sinitsinmike/Build-your-own-SH-101-CV-GATE-sequencer-/picture_pc_d4e4c39e6fc0b734aa8125e9d854be4d (1).webp

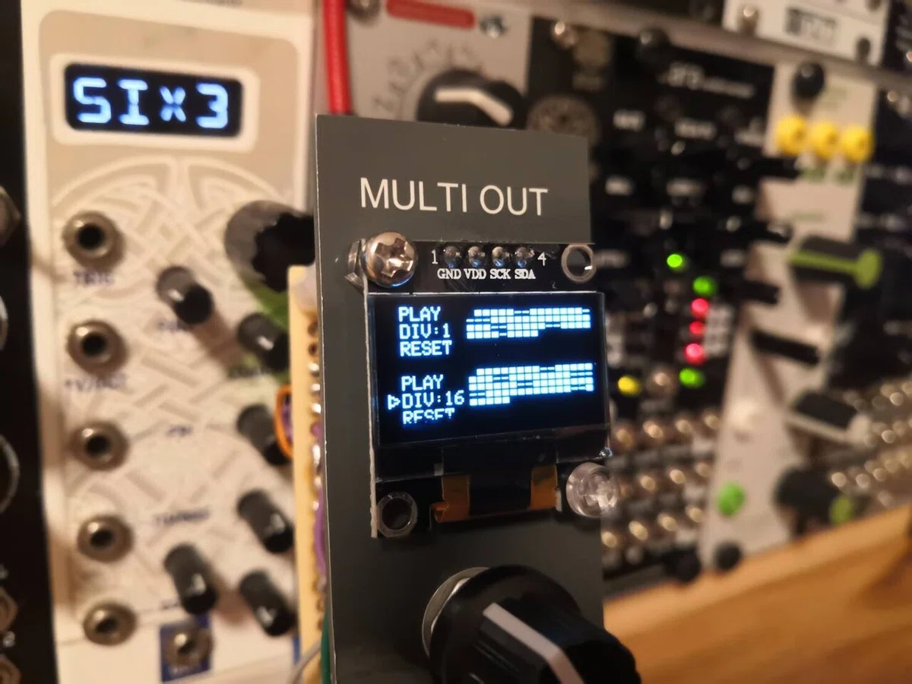
picture_pc_d4e4c39e6fc0b734aa8125e9d854be4d (1).webp
