sinitsinmike/Build-your-own-SH-101-CV-GATE-sequencer-/picture_pc_82b77ba2df97fa1968868f873a21f4f6.webp

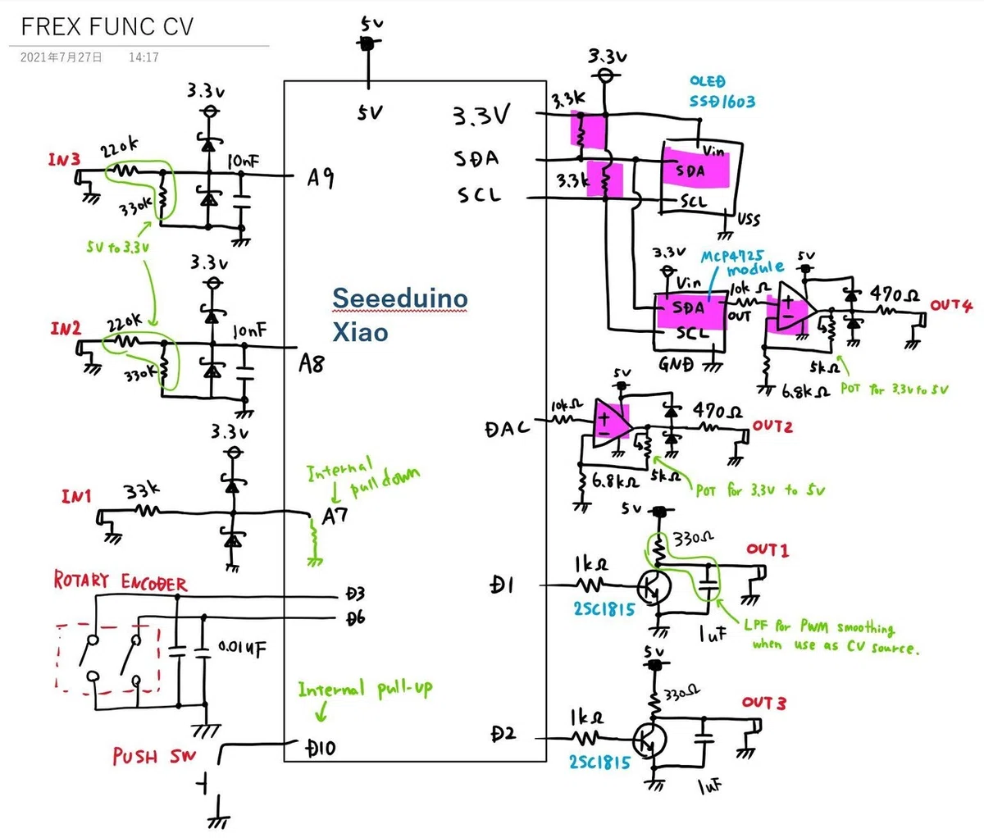
picture_pc_82b77ba2df97fa1968868f873a21f4f6.webp
